SeanDS/slow-cooker/README.md

slow-cooker
===========

Raspberry Pi scripts for controlling a hacked slow cooker.

Schematics for the controller electronics coming later...

Sean Leavey
https://github.com/SeanDS/
