SeanDS/slow-cooker/hardware/v1/bezel.fcstd

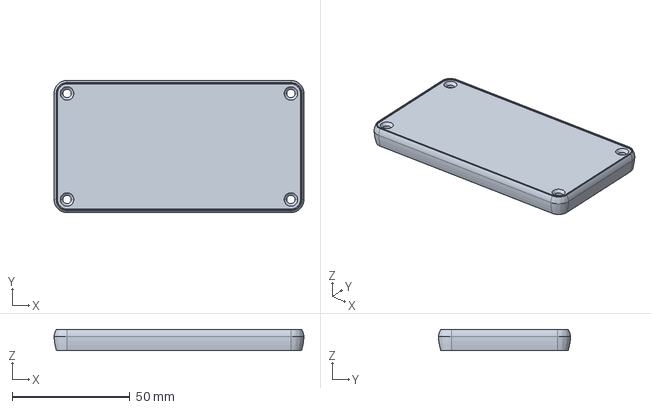
[picture p1: CAD file, 2017-07-26, an earlier design]
hardware/v1/bezel.fcstd
106.1 x 56.1 x 9.00 mm
