SeanDS/slow-cooker/hardware/v1/enclosure.fcstd

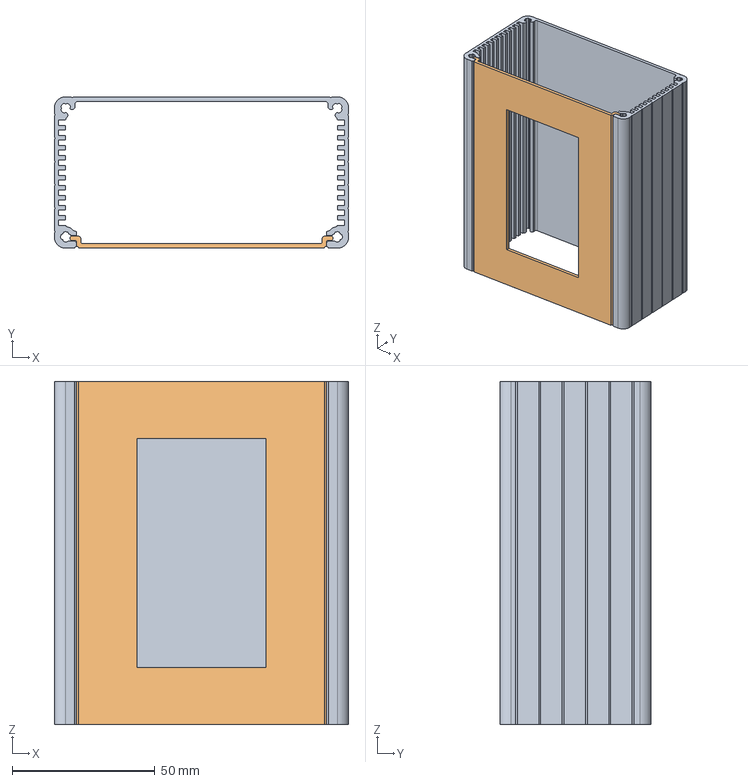
[picture p2: CAD file, 2017-07-26, an earlier design]
hardware/v1/enclosure.fcstd
103.0 x 53.0 x 120.0 mm
1455N Extrusion
