SeanDS/slow-cooker/hardware/v2/slow-cooker.kicad_pcb

## KiCad design hardware/v2/slow-cooker.kicad_pcb (2019-05-07)

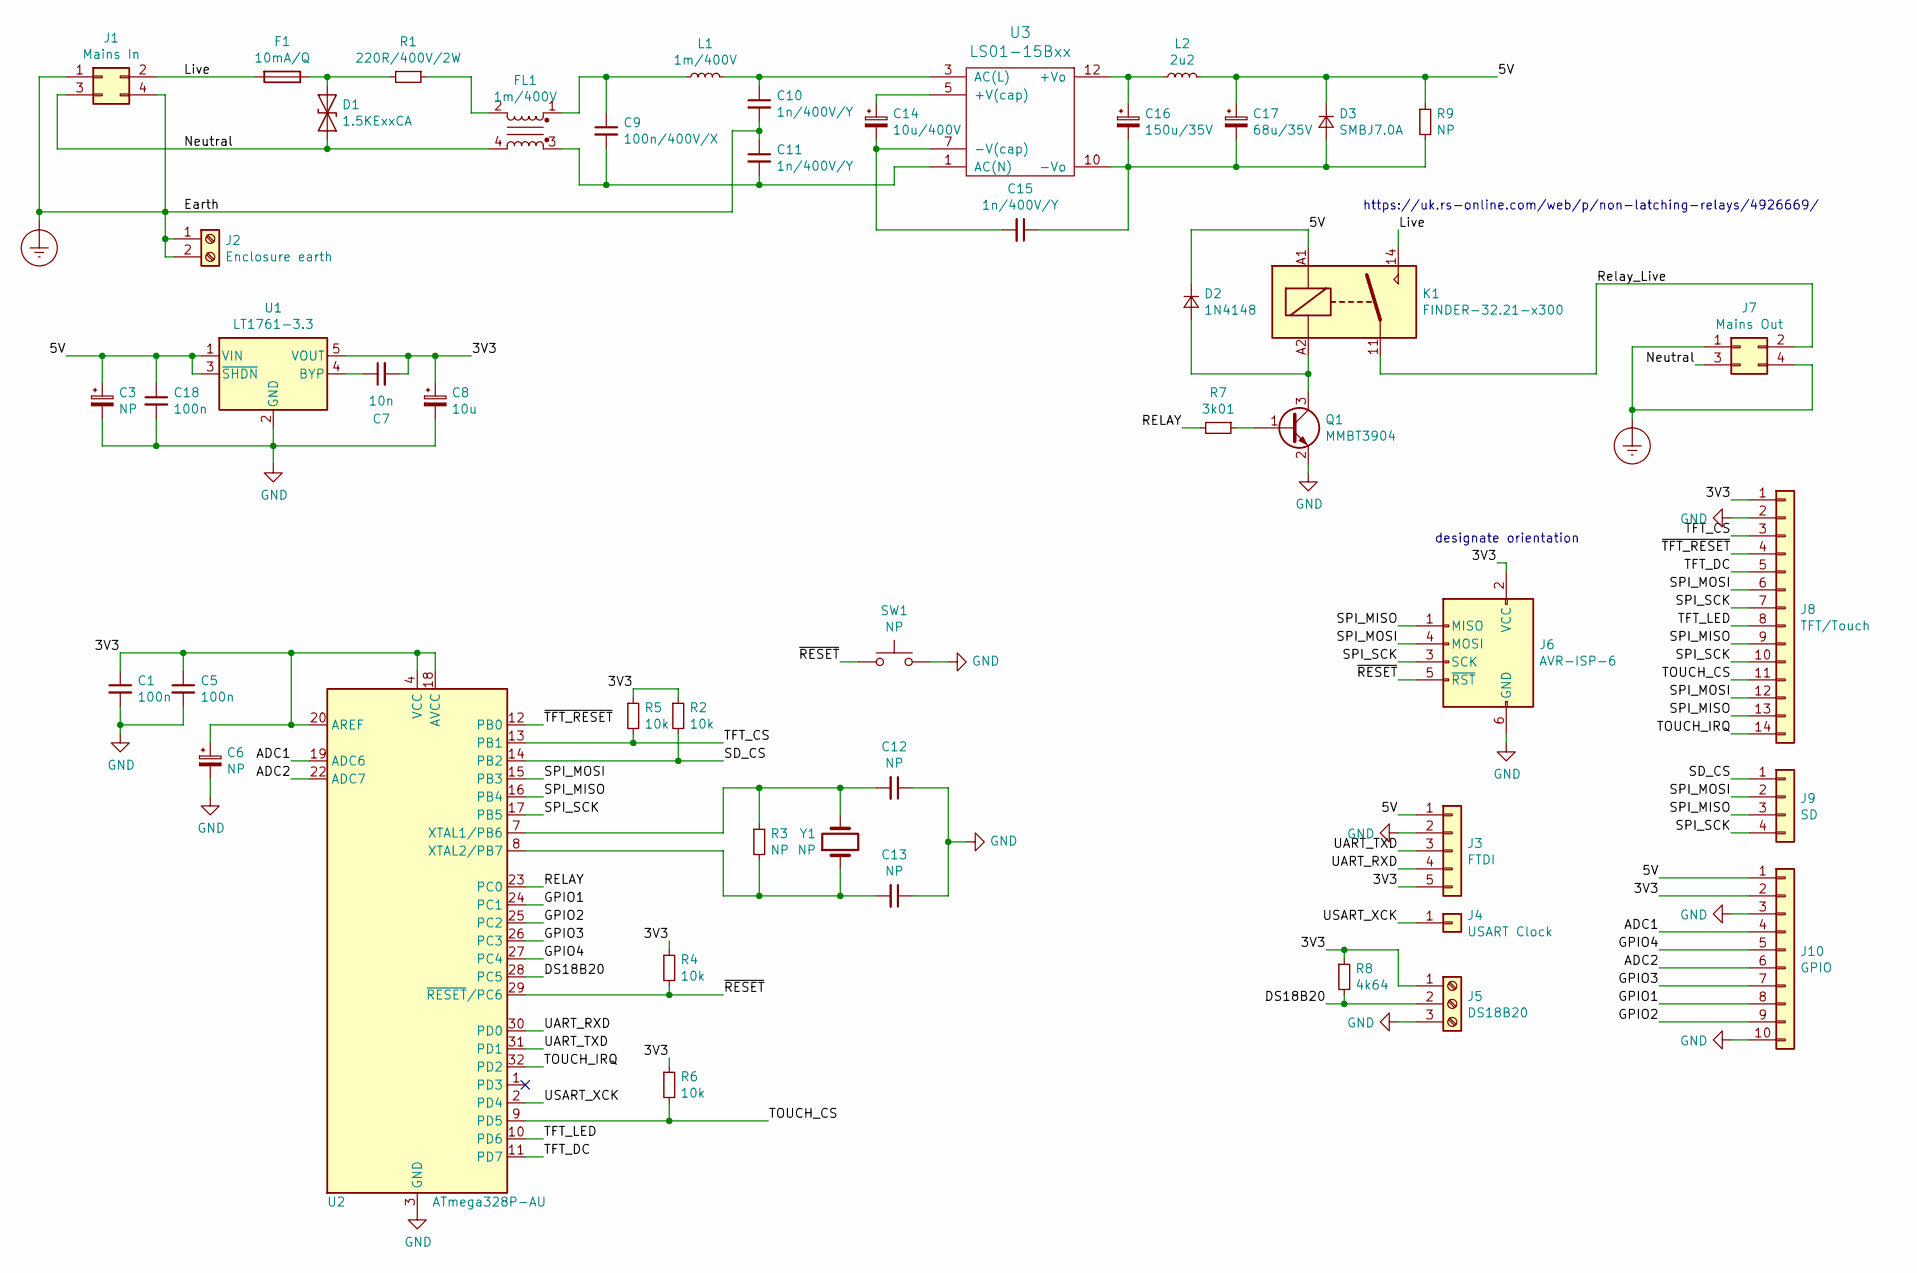
[picture p3: schematic slow-cooker.sch]

Parts:
C1, C5, C18: 100n; C_0805_2012Metric_Pad1.15x1.40mm_HandSolder
C3, C6: NP; CP_Radial_D5.0mm_P2.00mm
C7: 10n; C_0805_2012Metric_Pad1.15x1.40mm_HandSolder
C8: 10u; CP_Radial_D5.0mm_P2.00mm
C9: 100n/400V/X; C_Rect_L24_W7.6_P20.3
C10, C11, C15: 1n/400V/Y; C_Rect_L18.0mm_W5.0mm_P15.00mm_FKS3_FKP3
C12, C13: NP; C_0603_1608Metric_Pad1.05x0.95mm_HandSolder
C14: 10u/400V; CP_Radial_D12.5mm_P5.00mm
C16: 150u/35V; CP_Radial_D8.0mm_P3.50mm
C17: 68u/35V; CP_Radial_D6.3mm_P2.50mm
D1: 1.5KExxCA; D_DO-201AE_P15.24mm_Horizontal
D2: 1N4148; D_SMB_Handsoldering
D3: SMBJ7.0A; D_SMB_Handsoldering
F1: 10mA/Q; Wurth_64900001039
FL1: 1m/400V; CommonModeChoke_Epcos-B82730U
J1: Mains In; Molex_Mini-Fit_Jr_5566-04A_2x02_P4.20mm_Vertical
J2: Enclosure earth; TerminalBlock_Phoenix_MKDS-1,5-2-5.08_1x02_P5.08mm_Horizont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
J3: FTDI; PinHeader_1x05_P2.54mm_Vertical
J4: USART Clock; SolderWirePad_1x01_Drill1mm
J5: DS18B20; TerminalBlock_Phoenix_PT-1,5-3-3.5-H_1x03_P3.50mm_Horizontal
J6: AVR-ISP-6; PinHeader_2x03_P2.54mm_Vertical
J7: Mains Out; Molex_Mini-Fit_Jr_5566-04A_2x02_P4.20mm_Vertical
J8: TFT/Touch; PinSocket_1x14_P2.54mm_Vertical
J9: SD; PinSocket_1x04_P2.54mm_Vertical
J10: GPIO; PinHeader_2x05_P2.54mm_Vertical
K1: FINDER-32.21-x300; Relay_SPST_Finder_32.21-x300
L1: 1m/400V; L_Axial_L9.5mm_D4.0mm_P15.24mm_Horizontal_Fastron_SMCC
L2: 2u2; L_0805_2012Metric_Pad1.15x1.40mm_HandSolder
Q1: MMBT3904; SOT-23
R1: 220R/400V/2W; R_Axial_DIN0414_L11.9mm_D4.5mm_P15.24mm_Horizontal
R2, R4, R5, R6: 10k; R_0805_2012Metric_Pad1.15x1.40mm_HandSolder
R3, R9: NP; R_0805_2012Metric_Pad1.15x1.40mm_HandSolder
R7: 3k01; R_0805_2012Metric_Pad1.15x1.40mm_HandSolder
R8: 4k64; R_0805_2012Metric_Pad1.15x1.40mm_HandSolder
SW1: NP; SW_SPST_EVQP0
U1: LT1761-3.3; TSOT-23-5
U2: ATmega328P-AU; TQFP-32_7x7mm_P0.8mm
U3: LS01-15Bxx; Mornsun_LS01-15BxxSS
Y1: NP; Crystal_SMD_HC49-SD

Connections:
/3V3: C1.1, C5.1, C6.1, C7.2, C8.1, J3.5, J5.1, J6.2 (VCC), J8.1, J10.2, R2.1, R4.1, R5.1, R6.1, R8.1, U1.5 (VOUT), U2.4 (VCC), U2.6 (VCC), U2.18 (AVCC), U2.20 (AREF)
/5V: C3.1, C17.1, C18.1, D2.1 (K), D3.1 (K), J3.1, J10.1, K1.A1, L2.2, R9.1, U1.1 (VIN), U1.3 (~SHDN)
/ADC1: J10.4, U2.19 (ADC6)
/ADC2: J10.6, U2.22 (ADC7)
/DS18B20: J5.2, R8.2, U2.28 (PC5)
/GPIO1: J10.8, U2.24 (PC1)
/GPIO2: J10.9, U2.25 (PC2)
/GPIO3: J10.7, U2.26 (PC3)
/GPIO4: J10.5, U2.27 (PC4)
/Live: F1.2, J1.2, K1.14
/Neutral: D1.2 (A2), FL1.4, J1.3, J7.3
/RELAY: R7.2, U2.23 (PC0)
/Relay_Live: J7.2, K1.11
/SD_CS: J9.1, R2.2, U2.14 (PB2)
/SPI_MISO: J6.1 (MISO), J8.9, J8.13, J9.3, U2.16 (PB4)
/SPI_MOSI: J6.4 (MOSI), J8.6, J8.12, J9.2, U2.15 (PB3)
/SPI_SCK: J6.3 (SCK), J8.7, J8.10, J9.4, U2.17 (PB5)
/TFT_CS: J8.3, R5.2, U2.13 (PB1)
/TFT_DC: J8.5, U2.11 (PD7)
/TFT_LED: J8.8, U2.10 (PD6)
/TOUCH_CS: J8.11, R6.2, U2.9 (PD5)
/TOUCH_IRQ: J8.14, U2.32 (PD2)
/UART_RXD: J3.4, U2.30 (PD0)
/UART_TXD: J3.3, U2.31 (PD1)
/USART_XCK: J4.1, U2.2 (PD4)
/~RESET: J6.5 (~RST), R4.2, SW1.1, U2.29 (~RESET~/PC6)
/~TFT_RESET: J8.4, U2.12 (PB0)
Earth_Protective: C10.2, C11.1, J1.1, J1.4, J2.1, J2.2, J7.1, J7.4
GND: C1.2, C3.2, C5.2, C6.2, C8.2, C12.1, C13.1, C18.2, J3.2, J5.3, J6.6 (GND), J8.2, J10.3, J10.10, Q1.2 (E), SW1.2, U1.2 (GND), U2.3 (GND), U2.5 (GND), U2.21 (GND)
unnamed: C7.1, U1.4 (BYP)
unnamed: C9.1, FL1.1, L1.1
unnamed: C10.1, L1.2, U3.3 (AC(L))
unnamed: C9.2, C11.2, FL1.3, U3.1 (AC(N))
unnamed: C12.2, R3.1, U2.7 (XTAL1/PB6), Y1.2
unnamed: C13.2, R3.2, U2.8 (XTAL2/PB7), Y1.1
unnamed: C14.1, U3.5 (+V(cap))
unnamed: C14.2, C15.2, U3.7 (-V(cap))
unnamed: C15.1, C16.2, C17.2, D3.2 (A), R9.2, U3.10 (-Vo)
unnamed: C16.1, L2.1, U3.12 (+Vo)
unnamed: D1.1 (A1), F1.1, R1.2
unnamed: D2.2 (A), K1.A2, Q1.3 (C)
unnamed: FL1.2, R1.1
unnamed: Q1.1 (B), R7.1

Notes on the sheet:
designate orientation
https://uk.rs-online.com/web/p/non-latching-relays/4926669/

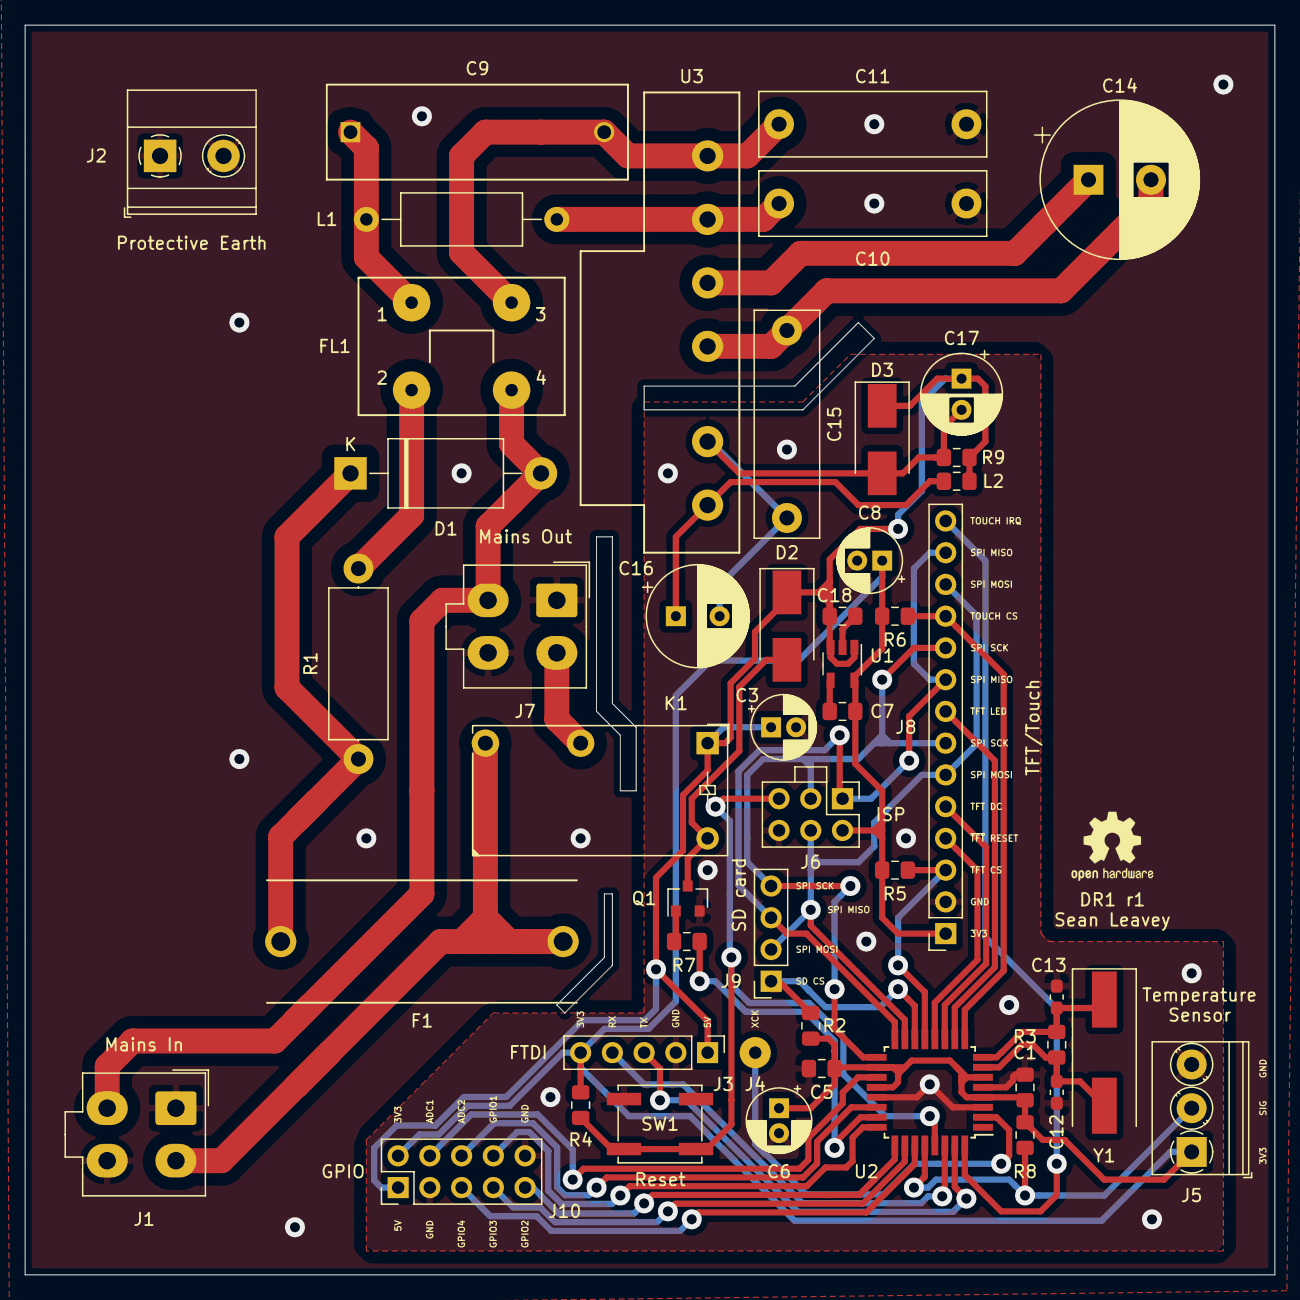
[picture p4: board hardware/v2/slow-cooker.kicad_pcb from above]

Board: 2 copper layers, 100.0 x 100.0 mm, 50 parts (0 on the bottom side), 43 nets.

Other parts of the board:
Ref**: 100mmx100mm
