SeanDS/slow-cooker/hardware/v1/slow-cooker.kicad_pcb

## KiCad design hardware/v1/slow-cooker.kicad_pcb (2017-08-20, an earlier design)

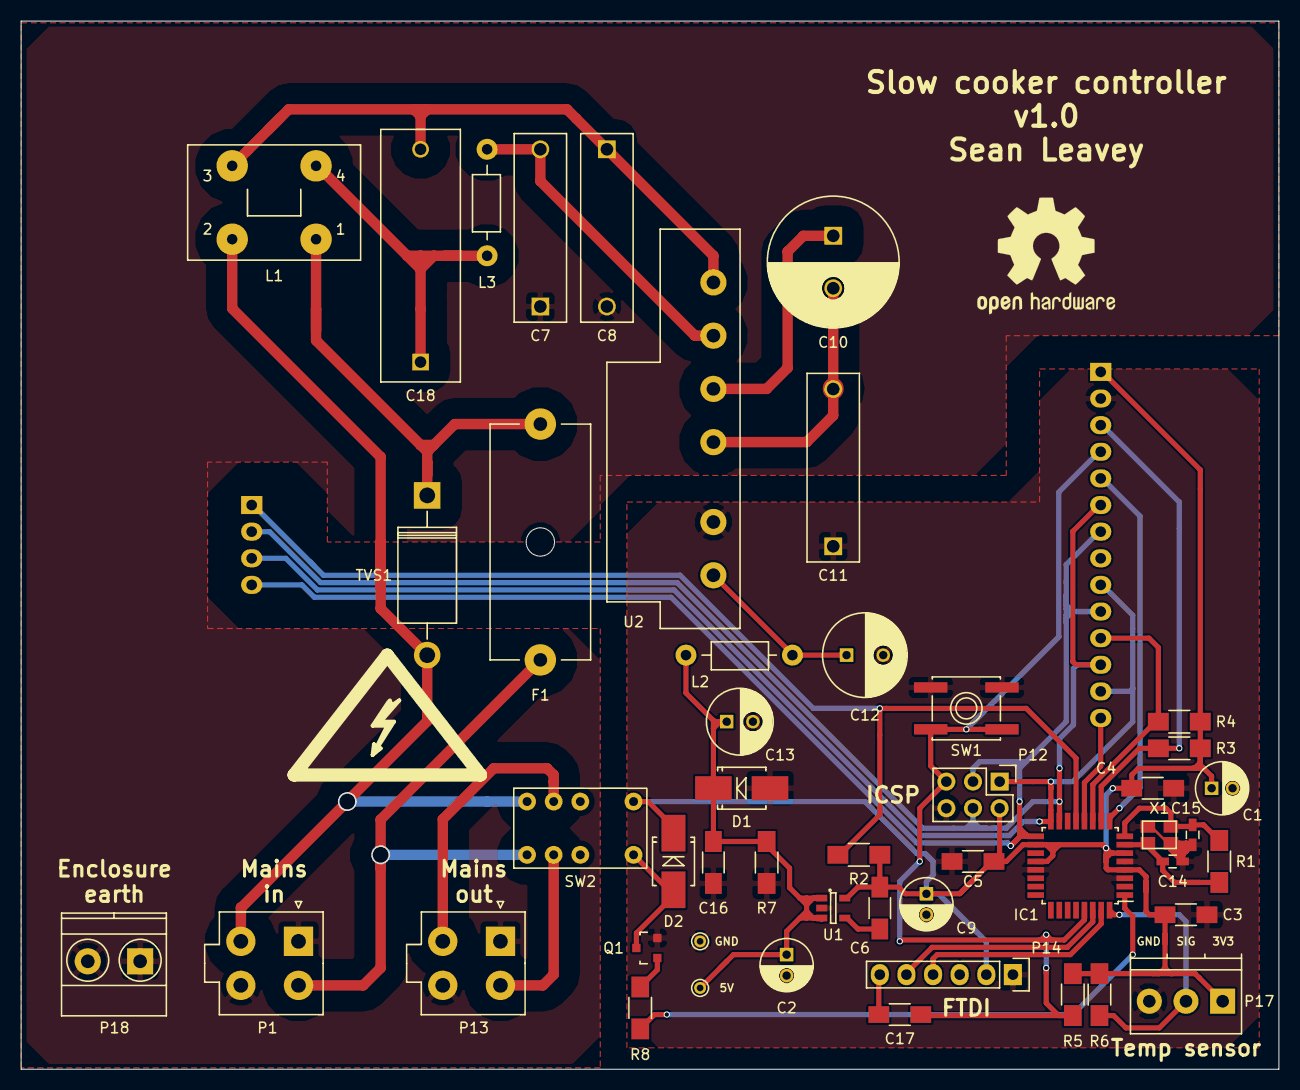
[picture p5: board hardware/v1/slow-cooker.kicad_pcb from above]

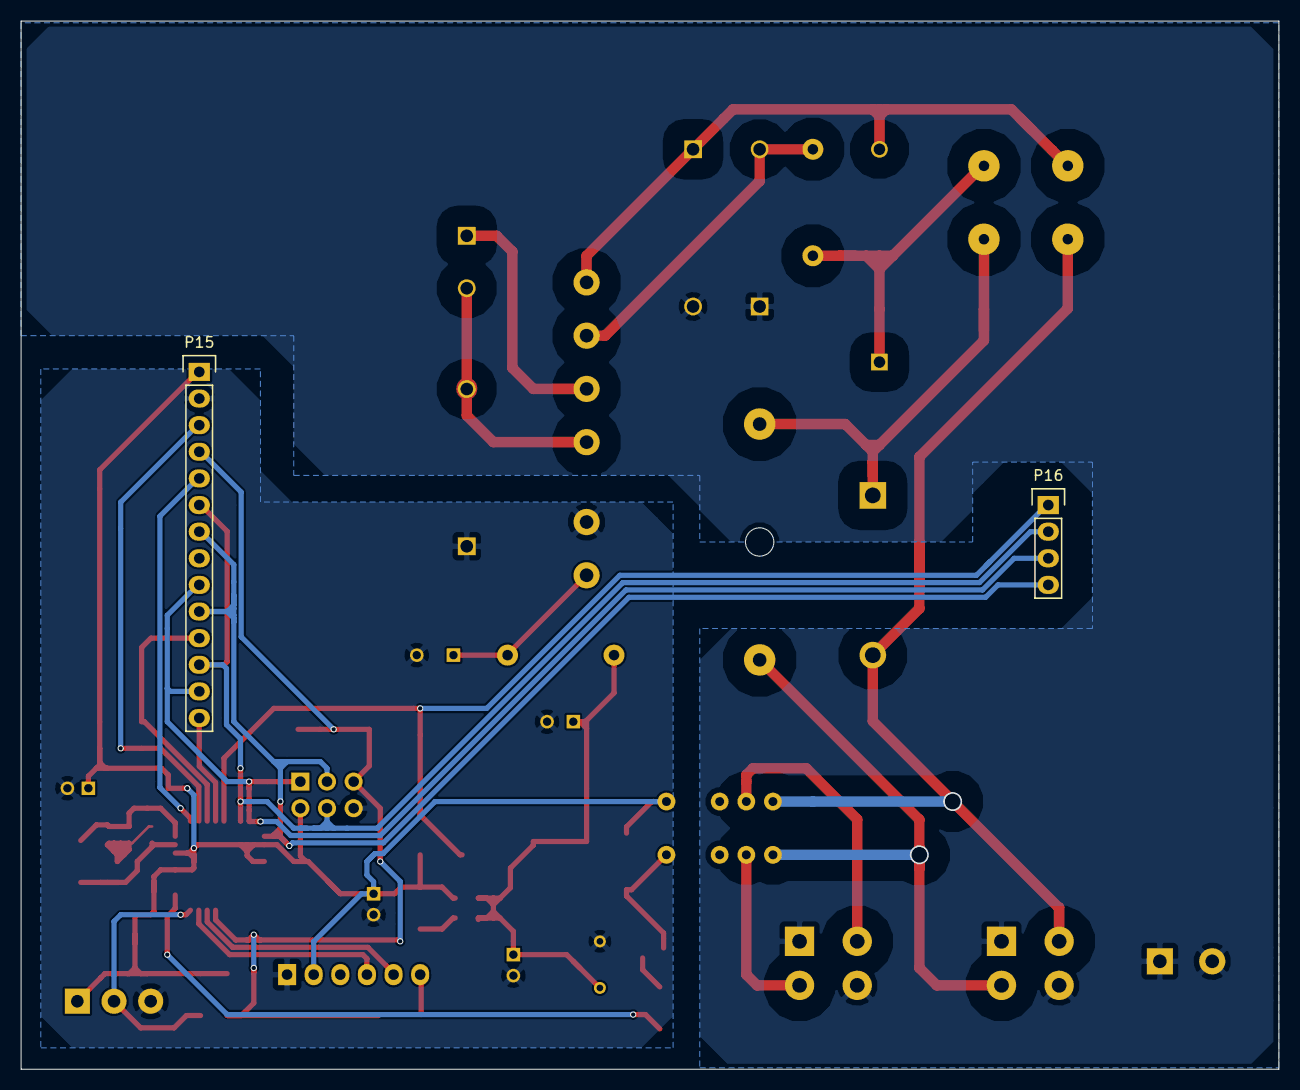
[picture p6: board hardware/v1/slow-cooker.kicad_pcb from below]

Board: 2 copper layers, 120.0 x 100.0 mm, 51 parts (2 on the bottom side), 34 nets.

Parts:
C1, C2, C9: 10u; C_Radial_D5_L11_P2
C3, C4, C5, C6: 10n; C_1206_HandSoldering
C7, C8, C11: 1n/400V/Y; C_Rect_L18_W5_P15
C10: 10u/400V; C_Radial_D12.5_L25_P5
C12: 150u; C_Radial_D8_L11.5_P3.5
C13: 68u; C_Radial_D6.3_L11.2_P2.5
C14, C15: 12p; C_0603_HandSoldering
C16, C17: 100n; C_1206_HandSoldering
C18: 100n/400V/X; C_Rect_L24_W7.6_P20.3
D1: SMBJ7.0A; SMB_Handsoldering
D2: STTH212U; SMB_Handsoldering
F1: 10mA, Q; Fuseholder5x20_horiz_open_Schurter_0031_8201
IC1: ATMEGA328-AN; TQFP-32_7x7mm_Pitch0.8mm
L1: 1m/400V; CommonModeChoke_Epcos-B82730U
L2: 2.2u; Choke_Horizontal_RM10mm
L3: 1m/400V; Choke_Horizontal_RM10mm
P1: Input; Molex_MiniFit-JR-5556-04A_2x02x4.20mm_Straight
P10: TEST_5V; PINTST
P11: TEST_GND; PINTST
P12: ICSP; Pin_Header_Straight_2x03
P13: Output; Molex_MiniFit-JR-5556-04A_2x02x4.20mm_Straight
P14: FTDI; Pin_Header_Straight_1x06
P15: LCD 1; Pin_Header_Straight_1x14
P16: LCD 2; Pin_Header_Straight_1x04
P17: Temperature sensor; TerminalBlock_Pheonix_PT-3.5mm_3pol
P18: Enclosure earth; TerminalBlock_Pheonix_MKDS1.5-2pol
Q1: MMBT3904; SOT-23
R1: 1M; R_1206_HandSoldering
R2, R3, R4, R5, R8: 10k; R_1206_HandSoldering
R6: 4k7; R_1206_HandSoldering
R7: NP; R_1206_HandSoldering
Ref**: Val**; 100mmx120mm
SW1: Reset; SW_SPST_EVQP0
SW2: TE D3223; FX2 D3223
TVS1: 1.5KE300CA1; Diode_DO-201AD_Horizontal_RM15
U1: LT1761-3.3; SOT-23-5
U2: LS01-15B05S; RS_Pro_LS01
X1: 16MHz; crystal_FA238-TSX3225

Connections:
/3V3: C1.1, C3.2, C4.2, C5.2, C6.1, C9.1, D2.1, IC1.4, IC1.6, IC1.18, IC1.20, P12.2, P14.2, P15.1, P17.1, R2.1, R3.1, R4.1, R5.1, R6.1, SW2.1, U1.5
/5V: C2.1, C13.1, C16.1, D1.1, L2.2, P10.1, R7.1, U1.1, U1.3
/DS18B20: IC1.32, P17.2, R6.2
/Live: F1.1, P1.2, SW2.6
/Neutral: L1.2, P1.3, SW2.5, TVS1.2
/RELAY: IC1.1, R8.2
/Relay_Live: P13.2, SW2.7
/Relay_Neutral: P13.3, SW2.4
/SD_CS: IC1.13, P16.1, R2.2
/SPI_MISO: IC1.16, P12.1, P15.9, P15.13, P16.3
/SPI_MOSI: IC1.15, P12.4, P15.6, P15.12, P16.2
/SPI_SCK: IC1.17, P12.3, P15.7, P15.10, P16.4
/TFT_CS: IC1.10, P15.3, R3.2
/TFT_D/C: IC1.9, P15.5
/T_CS: IC1.11, P15.11, R4.2
/T_IRQ: IC1.12, P15.14
/USART_RXD: IC1.30, P14.5
/USART_TXD: IC1.31, P14.4
/~RESET: C17.1, IC1.29, P12.5, P15.4, R5.2, SW1.1
Earth_Protective: C7.1, C8.2, P1.1, P1.4, P13.1, P13.4, P18.1, P18.2
GND: C1.2, C2.2, C3.1, C4.1, C5.1, C9.2, C11.1, C12.2, C13.2, C14.2, C15.2, C16.2, D1.2, IC1.3, IC1.5, IC1.21, P11.1, P12.6, P14.1, P15.2, P17.3, Q1.2, R7.2, SW1.2, U1.2, U2.10, X1.3
unnamed: C6.2, U1.4
unnamed: C7.2, L3.2, U2.3
unnamed: C10.1, U2.5
unnamed: C10.2, C11.2, U2.7
unnamed: C12.1, L2.1, U2.12
unnamed: C14.1, IC1.7, R1.1, X1.2
unnamed: C15.1, IC1.8, R1.2, X1.1
unnamed: C17.2, P14.6
unnamed: C18.1, L1.4, L3.1
unnamed: C8.1, C18.2, L1.3, U2.1
unnamed: D2.2, Q1.3, SW2.10
unnamed: F1.2, L1.1, TVS1.1
unnamed: Q1.1, R8.1
