SeanDS/slow-cooker/(commit log)

2017-07-24 Preliminary schematic
    [slow-cooker.sch]
2017-07-26 First enclosure attempt
    [bezel.fcstd, enclosure.fcstd]
2017-08-20 Board layout
    [slow-cooker-B.Cu.gbr, slow-cooker-B.Mask.gbr, slow-cooker-B.SilkS.gbr, slow-cooker-Edge.Cuts.gbr, slow-cooker-F.Cu.gbr, slow-cooker-F.Mask.gbr, slow-cooker-F.SilkS.gbr, slow-cooker-NPTH.drl]
2019-05-07 Move v1
    [bezel.fcstd, enclosure.fcstd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]
2019-05-07 Add v2
    [slow-cooker-B_Cu.gbr, slow-cooker-B_Mask.gbr, slow-cooker-B_Paste.gbr, slow-cooker-B_SilkS.gbr, slow-cooker-Edge_Cuts.gbr, slow-cooker-F_Cu.gbr, slow-cooker-F_Mask.gbr, slow-cooker-F_Paste.gbr]
